LaboratorioGluon/Picaro/README.md

# Picaro project

The picaro project is a HAB Picoballoon developed from scratch live on Twitch/Youtube.

## Objectives

- Float at around 13km height.
- Report sensor data to ground using LoRa.
- Last at least a couple of days alive.
