LaboratorioGluon/Picaro/Schematics/Picaro_vA.1.1.dxf

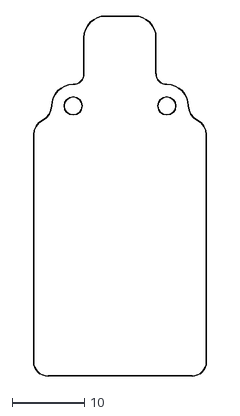
[picture p1: CAD file, 2025-08-20]
Schematics/Picaro_vA.1.1.dxf
24.0 x 50.0
