LaboratorioGluon/Picaro/Schematics/PicoBalloon/3d/PicoBalloon.step

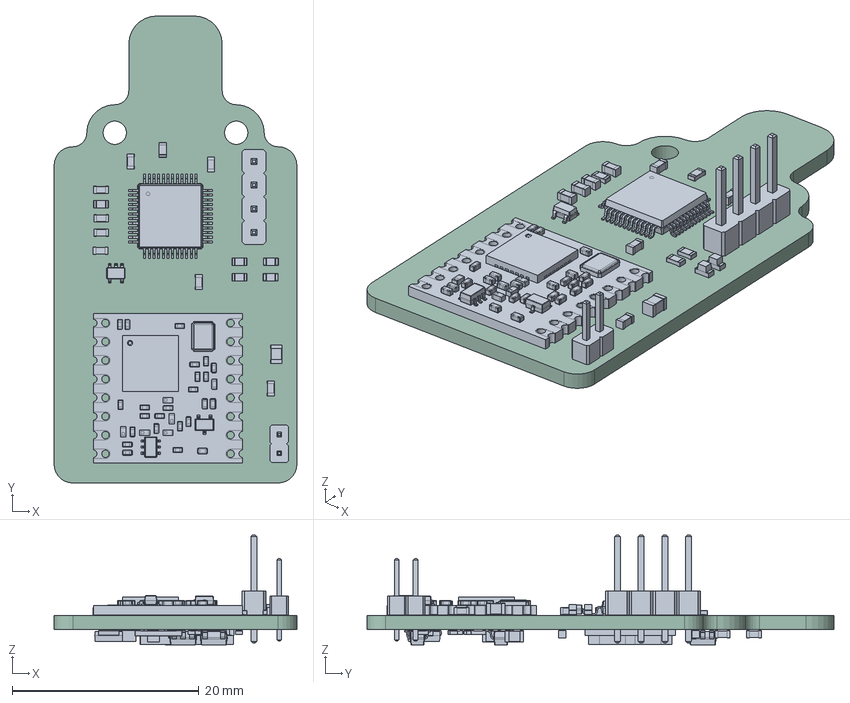
[picture p2: CAD file, 2025-08-02]
Schematics/PicoBalloon/3d/PicoBalloon.step
26.0 x 50.0 x 11.8 mm
C_0603_1608Metric x 11
PinHeader_1x04_P2.54mm_Vertical
LQFP-48_7x7mm_P0.5mm
LED_0603_1608Metric x 2
R_0603_1608Metric x 10
PinHeader_1x02_P2.00mm_Vertical
C_0805_2012Metric x 3
QFN 28 v2
SMD Crystal v1
CAP 0403 v1 x 8
CAP Ceramic 0403 v1 x 8
Res 0403 v1 x 4
CAP ML 0403 v1 x 5
SOT-323 v1
Inductor SMD 0403 v1 x 5
SOT-363 v1
SOT-353_SC-70-5
SOT-23-6 x 2
L_0603_1608Metric
SOT-23-5
ATGM336H
R_2010_5025Metric
CP_EIA-3528-12_Kemet-T
L_1008_2520Metric
PicoBalloon_PCB
