LaboratorioGluon/Picaro/Schematics/PicoBalloon1.FCStd

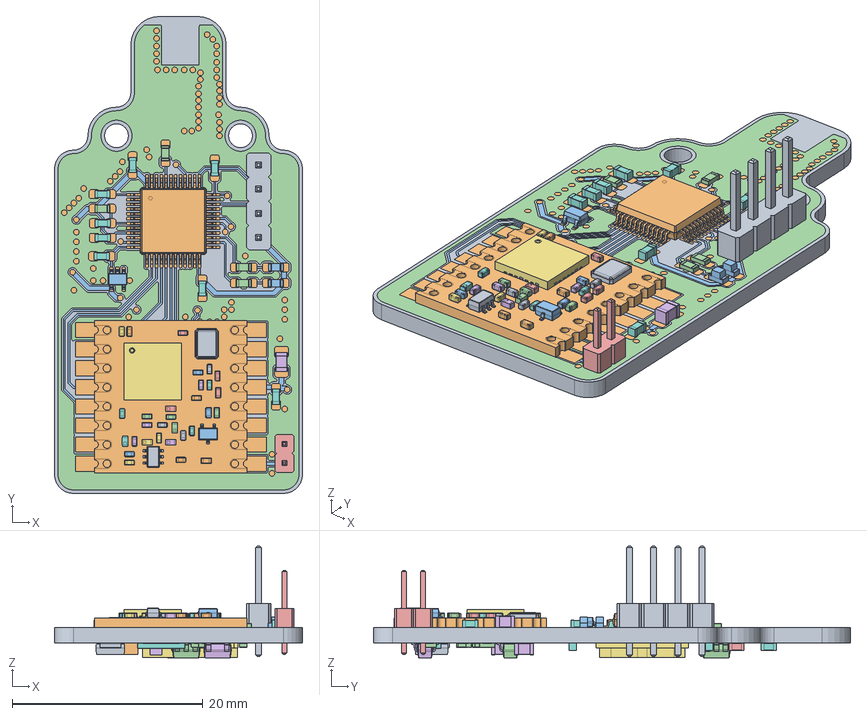
[picture p3: CAD file, 2025-08-02]
Schematics/PicoBalloon1.FCStd
26.0 x 50.0 x 11.7 mm
Pcb_fc6c
topPads_fc6c
topTracks_fc6c
topZones_fc6c
botPads_fc6c
botTracks_fc6c
botZones_fc6c
C7_C_0603_1608Metric_4bac665c0328 x 11
J4_PinHeader_1x04_P254mm_Vertical_e08cb0b54970
U4_LQFP-48_7x7mm_P0.5mm_77237e435faf
D1_LED_0603_1608Metric_d956694ae5bc x 2
R6_R_0603_1608Metric_1e168342529a x 10
J3_PinHeader_1x02_P200mm_Vertical_b3f72112f0fe
C4_C_0805_2012Metric_6482b1569bd5 x 3
QFN 28 v2
QFN 28 v003
QFN 28 v004
QFN 28 v005
QFN 28 v006
QFN 28 v007
QFN 28 v008
QFN 28 v009
QFN 28 v010
QFN 28 v011
QFN 28 v012
QFN 28 v013
QFN 28 v014
QFN 28 v015
QFN 28 v016
QFN 28 v017
QFN 28 v018
QFN 28 v019
QFN 28 v020
QFN 28 v021
QFN 28 v022
QFN 28 v023
QFN 28 v024
QFN 28 v025
QFN 28 v026
QFN 28 v027
QFN 28 v028
QFN 28 v029
QFN 28 v030
QFN 28 v031
QFN 28 v032
QFN 28 v033
QFN 28 v034
QFN 28 v035
QFN 28 v036
QFN 28 v037
QFN 28 v038
QFN 28 v039
QFN 28 v040
QFN 28 v041
QFN 28 v042
QFN 28 v043
QFN 28 v044
QFN 28 v045
QFN 28 v046
QFN 28 v047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
