LaboratorioGluon/Picaro/Schematics/ATGM336H.STEP

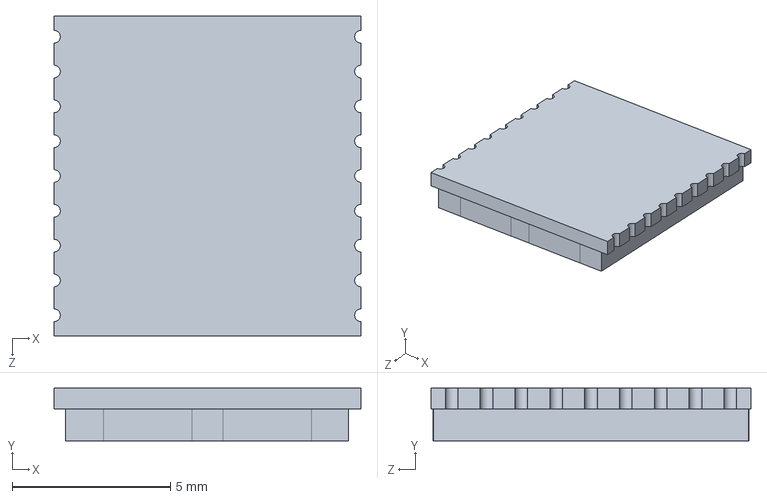
[picture p5: CAD file, 2025-08-02]
Schematics/ATGM336H.STEP
9.70 x 1.66 x 10.1 mm
