LaboratorioGluon/Picaro/Schematics/Picaro_v1.0.dxf

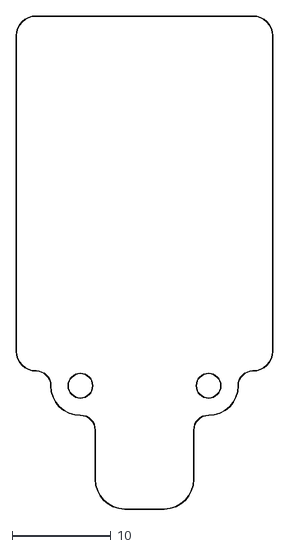
[picture p6: CAD file, 2025-07-31]
Schematics/Picaro_v1.0.dxf
26.0 x 50.0
