LaboratorioGluon/Picaro/Schematics/PicoBalloon/PicoBalloon.kicad_pcb

## KiCad design Schematics/PicoBalloon/PicoBalloon.kicad_pcb (2025-10-20)

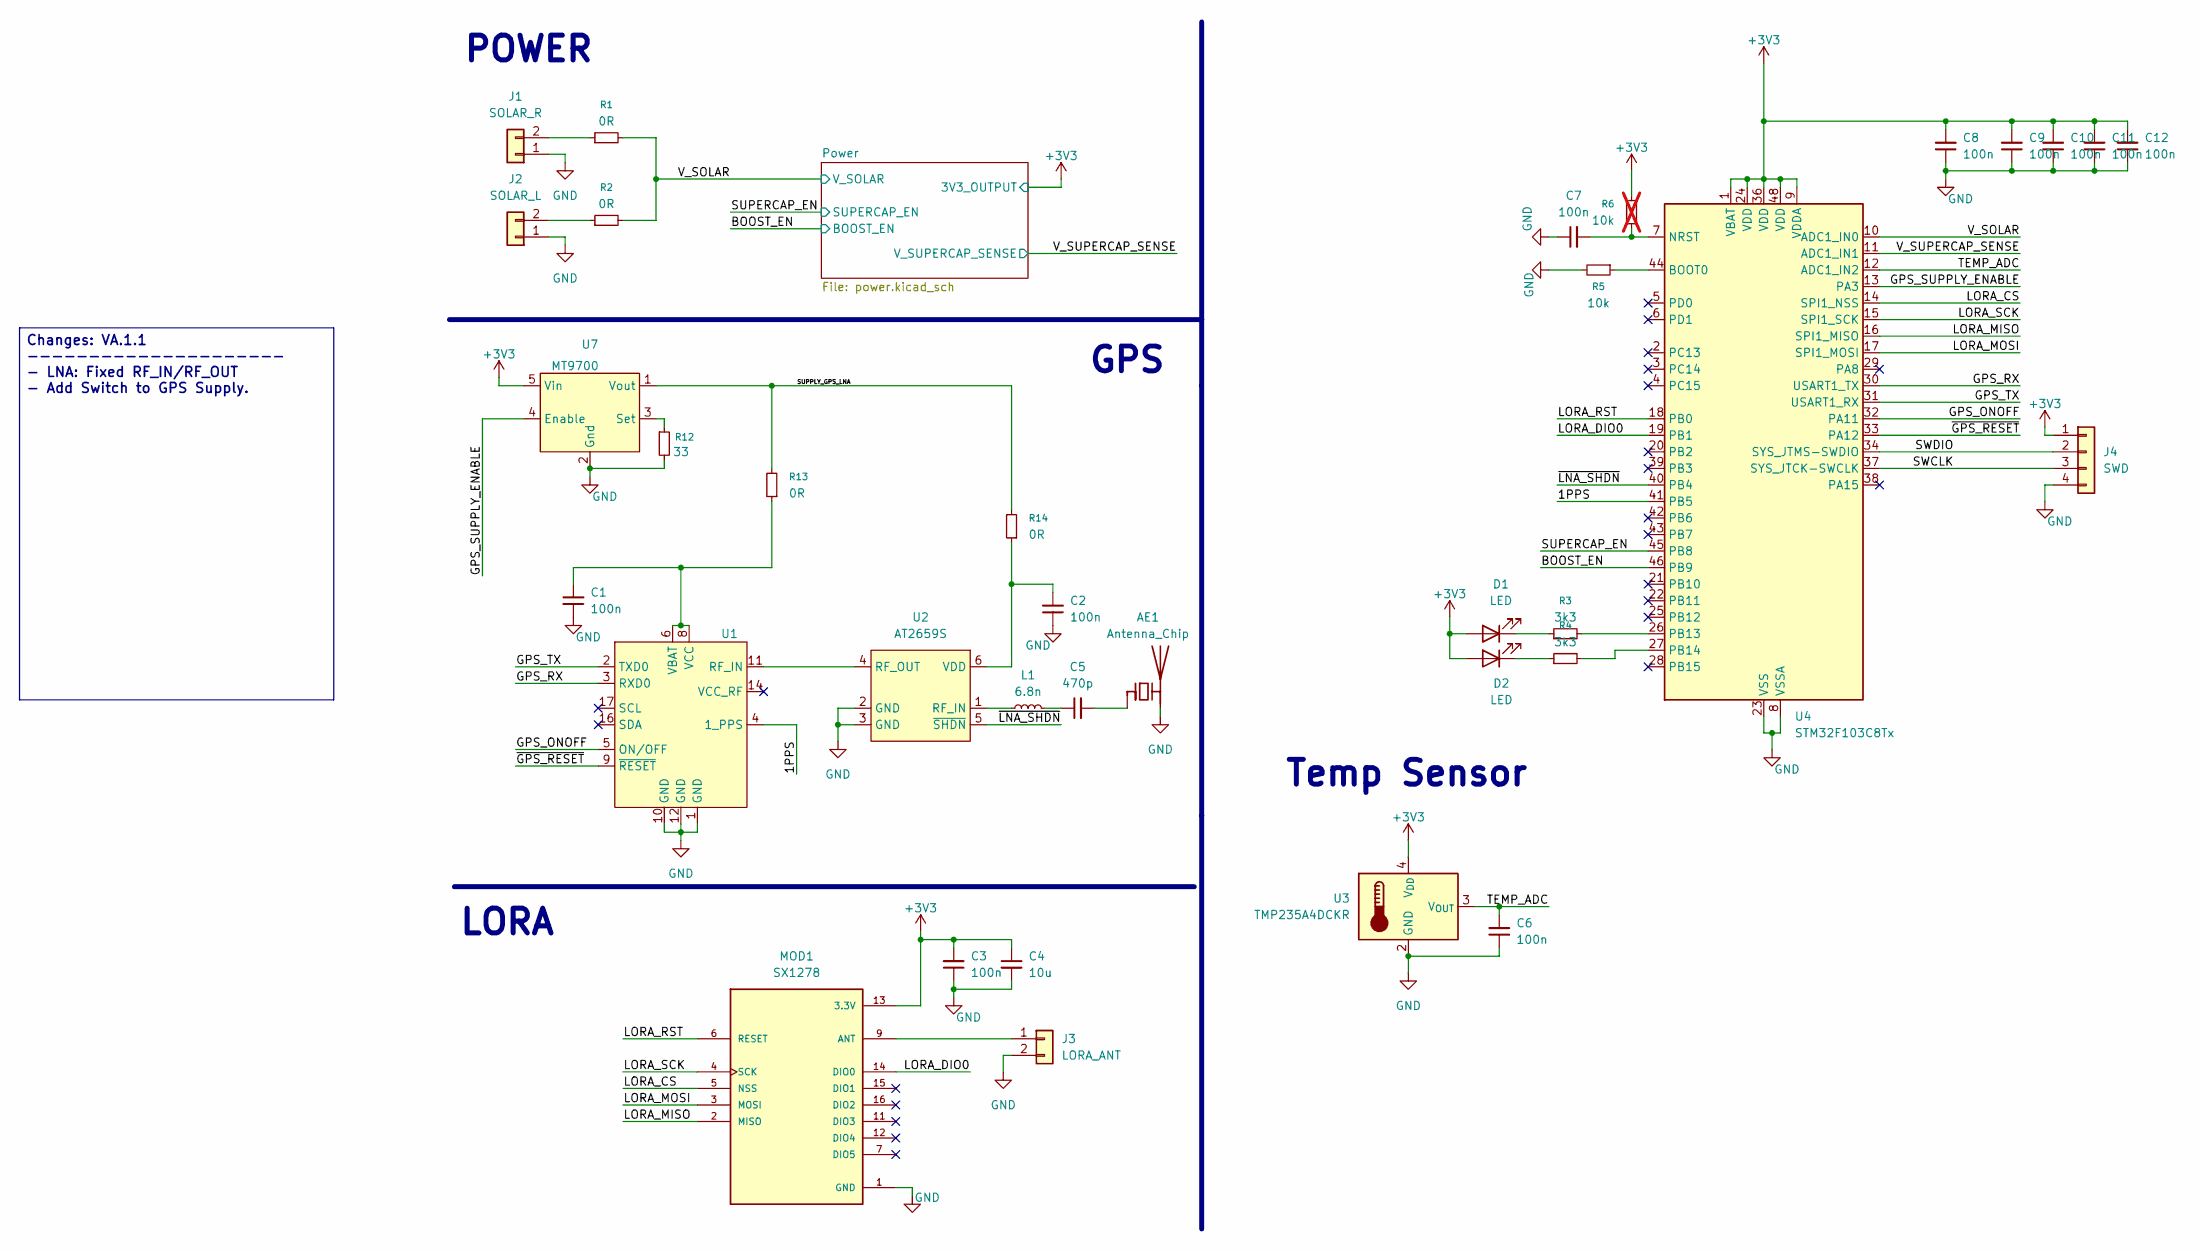
[picture p7: schematic PicoBalloon.kicad_sch, Picoballoon A.1.1]

Parts:
AE1: Antenna_Chip; Pulse_W3011
C1, C2, C3, C6, C7, C8, C9, C10, C11, C12: 100n; C_0603_1608Metric_Pad1.08x0.95mm_HandSolder
C4: 10u; C_0805_2012Metric_Pad1.18x1.45mm_HandSolder
C5: 470p; C_0603_1608Metric_Pad1.08x0.95mm_HandSolder
D1, D2: LED; LED_0603_1608Metric_Pad1.05x0.95mm_HandSolder
J1: SOLAR_R; 2_PAD_SMD
J2: SOLAR_L; 2_PAD_SMD
J3: LORA_ANT; PinHeader_1x02_P2.00mm_Vertical
J4: SWD; PinHeader_1x04_P2.54mm_Vertical
L1: 6.8n; L_0603_1608Metric_Pad1.05x0.95mm_HandSolder
MOD1: SX1278; PARTREV N/A
R1, R2, R13, R14: 0R; R_0603_1608Metric_Pad0.98x0.95mm_HandSolder
R3, R4: 3k3; R_0603_1608Metric_Pad0.98x0.95mm_HandSolder
R5: 10k; R_0603_1608Metric_Pad0.98x0.95mm_HandSolder
R6: 10k; R_0603_1608Metric_Pad0.98x0.95mm_HandSolder; not fitted
R12: 33; R_0603_1608Metric_Pad0.98x0.95mm_HandSolder
U1: ATGM336H
U2: AT2659S; SOT-23-6_Handsoldering
U3: TMP235A4DCKR; SOT-353_SC-70-5
U4: STM32F103C8Tx; LQFP-48_7x7mm_P0.5mm
U7: MT9700; SOT-23-5_HandSoldering

Connections:
+3V3: C3.2, C4.1, C8.2, C9.2, C10.2, C11.2, C12.2, D1.2 (A), D2.2 (A), J4.1, MOD1.13 (3.3V), R6.1, U3.4 (V_{DD}), U4.1 (VBAT), U4.9 (VDDA), U4.24 (VDD), U4.36 (VDD), U4.48 (VDD), U7.5 (Vin); also elsewhere on the board
/1PPS: U1.4 (1_PPS), U4.41 (PB5)
/BOOST_EN: U4.46 (PB9); also elsewhere on the board
/GPS_ONOFF: U1.5 (ON/OFF), U4.32 (PA11)
/GPS_RX: U1.3 (RXD0), U4.30 (USART1_TX)
/GPS_SUPPLY_ENABLE: U4.13 (PA3), U7.4 (Enable)
/GPS_TX: U1.2 (TXD0), U4.31 (USART1_RX)
/LORA_CS: MOD1.5 (NSS), U4.14 (SPI1_NSS)
/LORA_DIO0: MOD1.14 (DIO0), U4.19 (PB1)
/LORA_MISO: MOD1.2 (MISO), U4.16 (SPI1_MISO)
/LORA_MOSI: MOD1.3 (MOSI), U4.17 (SPI1_MOSI)
/LORA_RST: MOD1.6 (RESET), U4.18 (PB0)
/LORA_SCK: MOD1.4 (SCK), U4.15 (SPI1_SCK)
/SUPERCAP_EN: U4.45 (PB8); also elsewhere on the board
/SUPPLY_GPS_LNA: R13.2, R14.2, U7.1 (Vout)
/SWCLK: J4.3, U4.37 (SYS_JTCK-SWCLK)
/SWDIO: J4.2, U4.34 (SYS_JTMS-SWDIO)
/TEMP_ADC: C6.2, U3.3 (V_{OUT}), U4.12 (ADC1_IN2)
/V_SOLAR: R1.2, R2.2, U4.10 (ADC1_IN0); also elsewhere on the board
/V_SUPERCAP_SENSE: U4.11 (ADC1_IN1); also elsewhere on the board
/~GPS_RESET: U1.9 (~RESET), U4.33 (PA12)
/~LNA_SHDN: U2.5 (~SHDN), U4.40 (PB4)
GND: AE1.2 (PCB_Trace), C1.1, C2.1, C3.1, C4.2, C6.1, C7.1, C8.1, C9.1, C10.1, C11.1, C12.1, J1.1, J2.1, J3.2, J4.4, MOD1.1 (GND), MOD1.8 (GND), MOD1.10 (GND), R5.2, R12.2, U1.1 (GND), U1.10 (GND), U1.12 (GND), U2.2 (GND), U2.3 (GND), U3.2 (GND), U3.5 (GND), U4.8 (VSSA), U4.23 (VSS), U4.35 (VSS), U4.47 (VSS), U7.2 (Gnd); also elsewhere on the board
unnamed: AE1.1 (FEED), C5.2
unnamed: C5.1, L1.2
unnamed: D1.1 (K), R3.1
unnamed: D2.1 (K), R4.1
unnamed: J1.2, R1.1
unnamed: J2.2, R2.1
unnamed: J3.1, MOD1.9 (ANT)
unnamed: U1.11 (RF_IN), U2.4 (RF_OUT)
unnamed: C1.2, R13.1, U1.6 (VBAT), U1.8 (VCC)
unnamed: L1.1, U2.1 (RF_IN)
unnamed: C2.2, R14.1, U2.6 (VDD)
unnamed: R5.1, U4.44 (BOOT0)
unnamed: C7.2, R6.2, U4.7 (NRST)
unnamed: R3.2, U4.26 (PB13)
unnamed: R4.2, U4.27 (PB14)
unnamed: R12.1, U7.3 (Set)

Notes on the sheet:
Temp Sensor
POWER
LORA
GPS
Changes: VA.1.1 --------------------- - LNA: Fixed RF_IN/RF_OUT - Add Switch to GPS Supply.

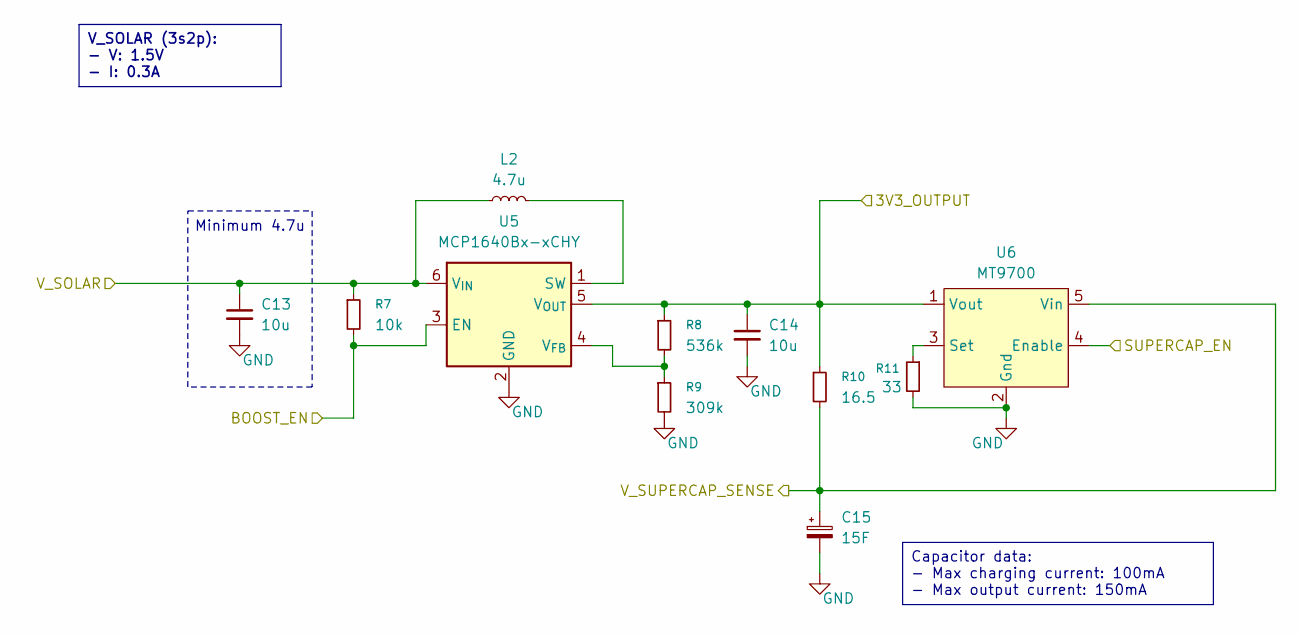
[picture p8: schematic power.kicad_sch, Picoballoon A.1.1]

Parts:
C13, C14: 10u; C_0805_2012Metric_Pad1.18x1.45mm_HandSolder
C15: 15F; CP_EIA-3528-12_Kemet-T_HandSolder
L2: 4.7u; L_1008_2520Metric_Pad1.43x2.20mm_HandSolder
R7: 10k; R_0603_1608Metric_Pad0.98x0.95mm_HandSolder
R8: 536k; R_0603_1608Metric_Pad0.98x0.95mm_HandSolder
R9: 309k; R_0603_1608Metric_Pad0.98x0.95mm_HandSolder
R10: 16.5; R_2010_5025Metric_Pad1.40x2.65mm_HandSolder
R11: 33; R_0603_1608Metric_Pad0.98x0.95mm_HandSolder
U5: MCP1640Bx-xCHY; SOT-23-6
U6: MT9700; SOT-23-5_HandSoldering

Connections:
+3V3: C14.1, R8.1, R10.1, U5.5 (V_{OUT}), U6.1 (Vout); also elsewhere on the board
/BOOST_EN: R7.2, U5.3 (EN); also elsewhere on the board
/SUPERCAP_EN: U6.4 (Enable); also elsewhere on the board
/V_SOLAR: C13.1, L2.1, R7.1, U5.6 (V_{IN}); also elsewhere on the board
/V_SUPERCAP_SENSE: C15.1, R10.2, U6.5 (Vin); also elsewhere on the board
GND: C13.2, C14.2, C15.2, R9.2, R11.2, U5.2 (GND), U6.2 (Gnd); also elsewhere on the board
unnamed: L2.2, U5.1 (SW)
unnamed: R8.2, R9.1, U5.4 (V_{FB})
unnamed: R11.1, U6.3 (Set)

Notes on the sheet:
Minimum 4.7u
V_SOLAR (3s2p): - V: 1.5V - I: 0.3A
Capacitor data: - Max charging current: 100mA - Max output current: 150mA

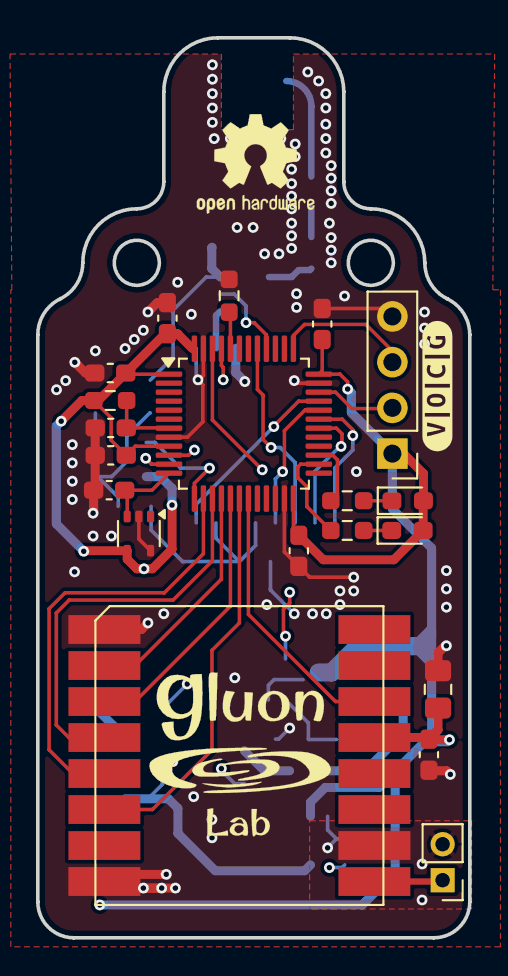
[picture p9: board PicoBalloon.kicad_pcb from above]

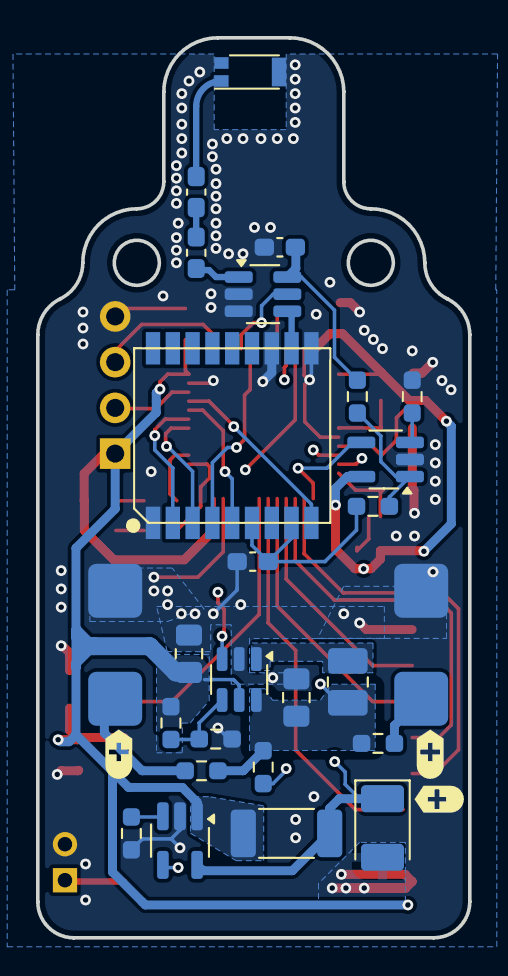
[picture p10: board PicoBalloon.kicad_pcb from below]

Board: 4 copper layers, 24.0 x 50.0 mm, 50 parts (29 on the bottom side), 42 nets.

Other parts of the board:
kibuzzard-68A4CDDF: G***; kibuzzard-68A4CDDF
kibuzzard-688BBDB2, kibuzzard-688BBDB2#2, kibuzzard-688BBDB2#3: G***; kibuzzard-688BBDB2
