LaboratorioGluon/Picaro/(commit log)

2025-07-25 GPS v1, BME removed, added temp sensor
    [PicoBalloon.kicad_sch]
2025-07-27 Updated Schematics for the Boost
    [PicoBalloon.kicad_sch]
2025-07-28 Finished schematic V1
    [PicoBalloon.kicad_pcb, PicoBalloon.kicad_sch, power.kicad_sch]
2025-07-28 Updated R10 size and datasheets
    [PicoBalloon.kicad_pcb, PicoBalloon.kicad_sch, power.kicad_sch]
2025-07-28 Fixed footprints and schematic symbols
    [PicoBalloon.kicad_pcb, PicoBalloon.kicad_sch, power.kicad_sch]
2025-07-29 First PCB layout
    [PicoBalloon.kicad_pcb, PicoBalloon.kicad_sch, power.kicad_sch]
2025-07-31 Version 1.0 provisional de la PCB
    [Picaro_v1.0.dxf, PicoBalloon.kicad_pcb, PicoBalloon.kicad_sch]
2025-07-31 Cleared groups in PCB
    [PicoBalloon.kicad_pcb]
2025-08-02 Added gerber files for v1.0
    [ATGM336H.STEP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]
2025-08-11 Added debug UART and improved GPIO initialization
2025-08-11 Added debug uart
2025-08-20 Started working on PCB A1.1
    [Picaro_vA.1.1.dxf, PicoBalloon.kicad_pcb, PicoBalloon.kicad_sch, power.kicad_sch]
2025-10-12 Updated PCB
    [power.kicad_sch]
2025-10-20 Version PCB A1.1
    [PicoBalloon-B_Cu.gbl, PicoBalloon-B_Mask.gbs, PicoBalloon-B_Paste.gbp, PicoBalloon-B_Silkscreen.gbo, PicoBalloon-Edge_Cuts.gm1, PicoBalloon-F_Cu.gtl, PicoBalloon-F_Mask.gts, PicoBalloon-F_Paste.gtp]
